GSH-LAN/esp32_env_sensors/esp32_gsh_env_sensors.kicad_sch

## KiCad design esp32_gsh_env_sensors.kicad_sch (2022-03-08, an earlier design)

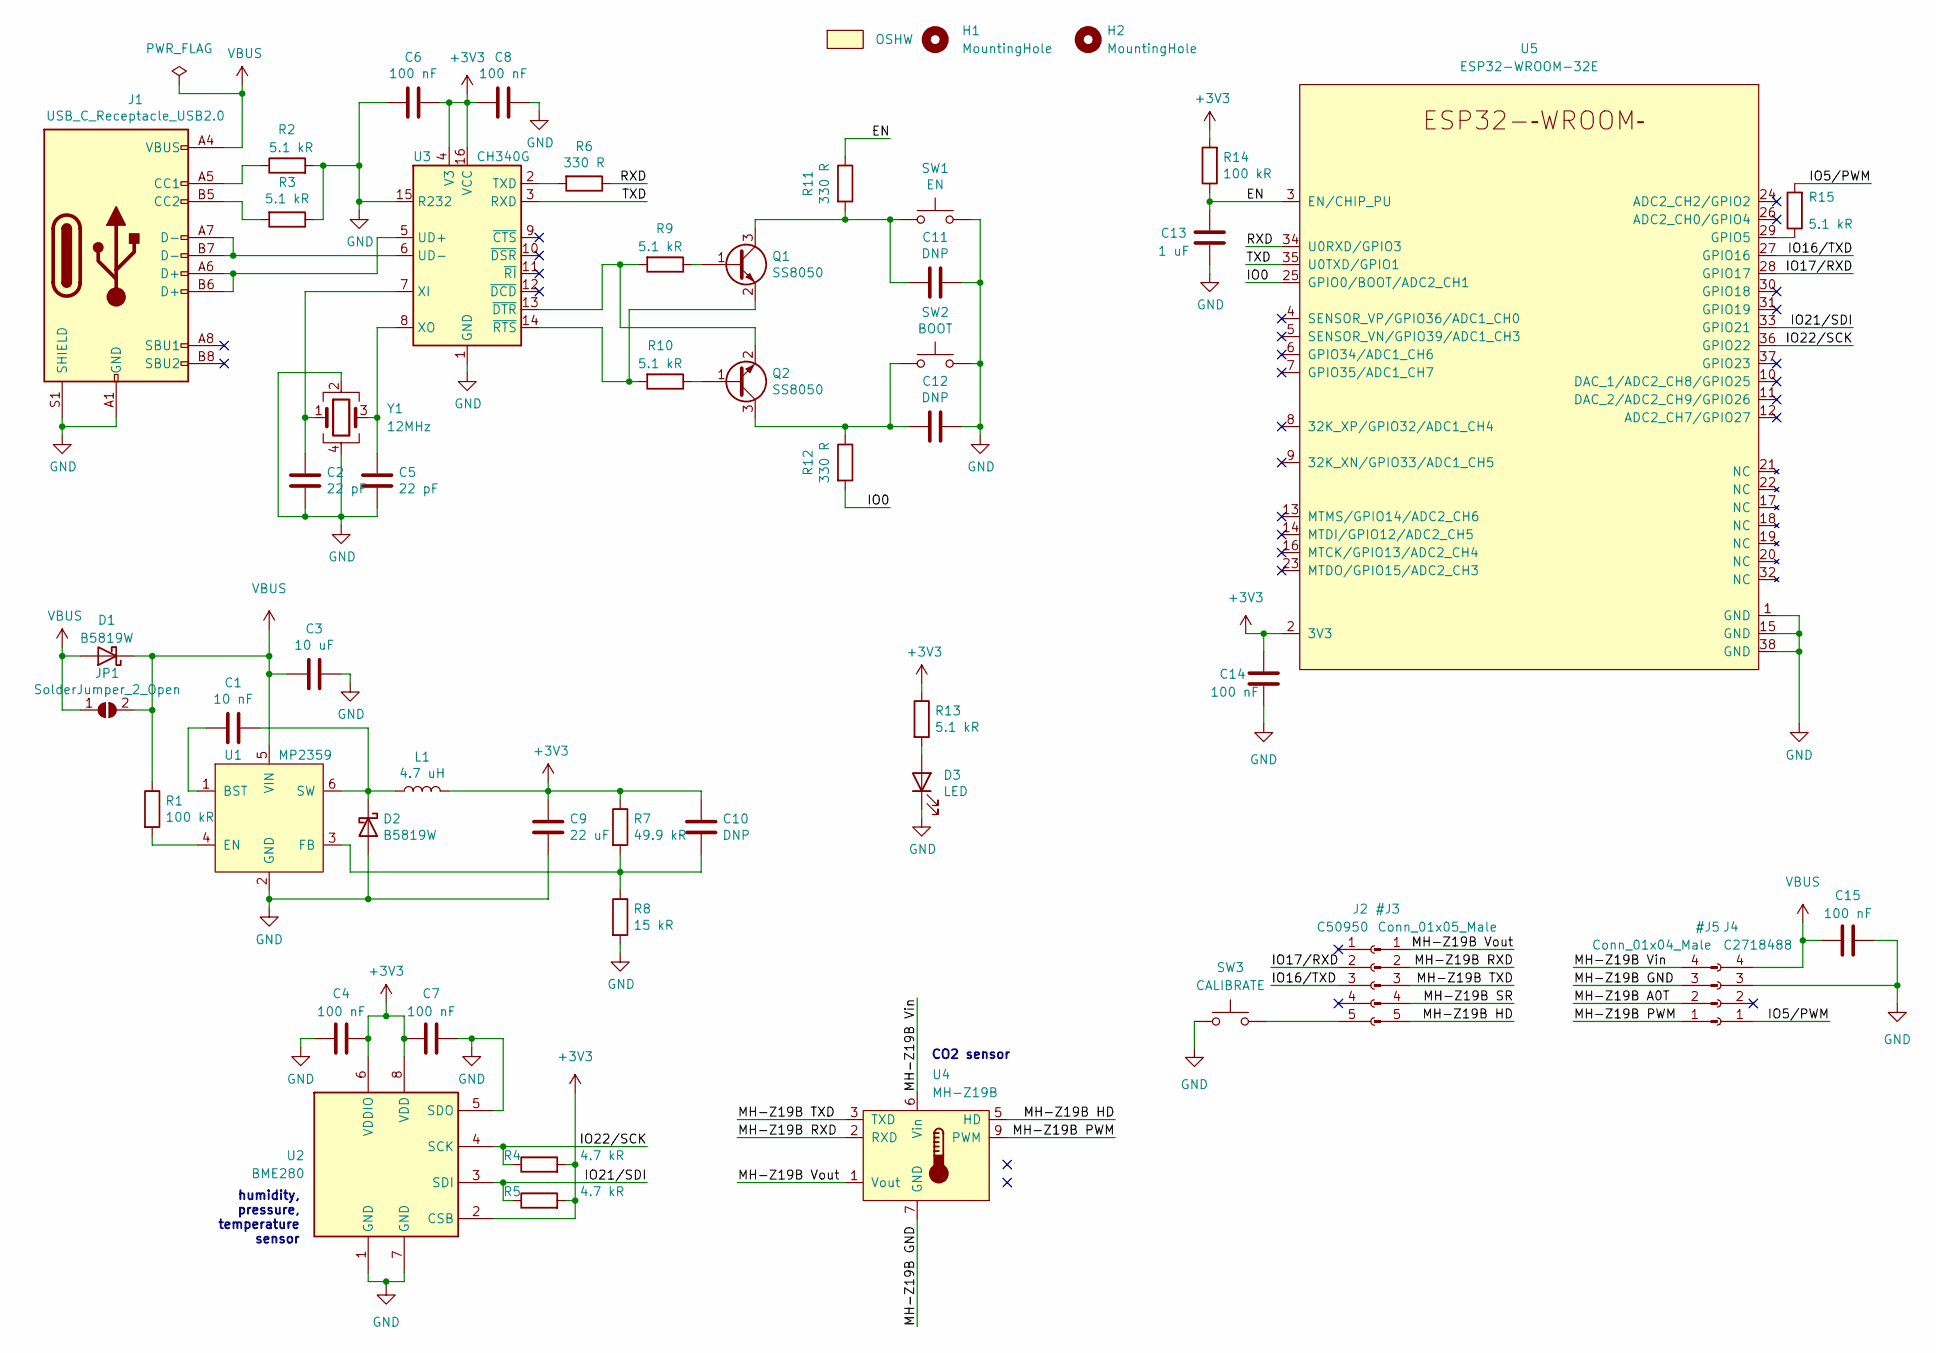
[picture p1: schematic esp32_gsh_env_sensors.kicad_sch]

Parts:
C1: 10 nF; C_0402_1005Metric; LCSC C15195
C2, C5: 22 pF; C_0402_1005Metric; LCSC C1555
C3: 10 uF; C_0805_2012Metric; LCSC C15850
C4, C6, C7, C8, C14, C15: 100 nF; C_0402_1005Metric; LCSC C1525
C9: 22 uF; C_0603_1608Metric; LCSC C59461
C10, C11, C12: DNP; C_0402_1005Metric_Pad0.74x0.62mm_HandSolder
C13: 1 uF; C_0402_1005Metric; LCSC C52923
D1, D2: B5819W; D_SOD-123; LCSC C8598
D3: LED; LED_0603_1608Metric_Castellated; LCSC C2286
H1, H2: MountingHole; ToolingHole_JLCSMT
I1: OSHW; OSHW-Logo2_9.8x8mm_SilkScreen
J1: USB_C_Receptacle_USB2.0; USB_C_Receptacle_Palconn_UTC16-G; LCSC C167321
J2: C50950; PinSocket_1x05_P2.54mm_Vertical; LCSC C50950
J4: C2718488; PinSocket_1x04_P2.54mm_Vertical; LCSC C2718488
JP1: SolderJumper_2_Open; SolderJumper-2_P1.3mm_Open_Pad1.0x1.5mm
L1: 4.7 uH; L_1210_3225Metric; LCSC C86070
Q1, Q2: SS8050; SOT-23; LCSC C2150
R1, R14: 100 kR; R_0402_1005Metric; LCSC C25741
R2, R3, R9, R10, R13, R15: 5.1 kR; R_0402_1005Metric; LCSC C25905
R4, R5: 4.7 kR; R_0402_1005Metric; LCSC C25900
R6, R11, R12: 330 R; R_0402_1005Metric; LCSC C25104
R7: 49.9 kR; R_0402_1005Metric; LCSC C25897
R8: 15 kR; R_0402_1005Metric; LCSC C25756
SW1: EN; SW_Push_SPST_NO_Alps_SKRK; LCSC C115357
SW2: BOOT; SW_Push_SPST_NO_Alps_SKRK; LCSC C115357
SW3: CALIBRATE; SW_Push_SPST_NO_Alps_SKRK; LCSC C115357
U1: MP2359; SOT-23-6; LCSC C14259
U2: BME280; Bosch_LGA-8_2.5x2.5mm_P0.65mm_ClockwisePinNumbering; LCSC C92489
U3: CH340G; SOIC-16_3.9x9.9mm_P1.27mm; LCSC C14267
U4: MH-Z19B; mh-z19b
U5: ESP32-WROOM-32E; LCSC C701343
Y1: 12MHz; Crystal_SMD_3225-4Pin_3.2x2.5mm; LCSC C9002

Connections:
+3V3: C4.2, C6.1, C7.1, C8.2, C9.1, C10.1, C14.1, L1.2, R4.2, R5.2, R7.1, R13.1, R14.2, U2.2 (CSB), U2.6 (VDDIO), U2.8 (VDD), U3.4 (V3), U3.16 (VCC), U5.2 (3V3)
Conn_01x04_Male: U4.6 (Vin), U4.7 (GND), U4.9 (PWM)
Conn_01x05_Male: U4.1 (Vout), U4.2 (RXD), U4.3 (TXD), U4.5 (HD)
EN: C13.1, R11.1, R14.1, U5.3 (EN/CHIP_PU)
GND: C2.2, C3.1, C4.1, C5.2, C6.2, C7.2, C8.1, C9.2, C11.1, C12.1, C13.2, C14.2, C15.2, D2.2 (A), D3.1 (K), J1.A1 (GND), J1.A12 (GND), J1.B1 (GND), J1.B12 (GND), J1.S1 (SHIELD), J4.3, R2.2, R3.1, R8.2, SW1.2, SW2.2, SW3.1, U1.2 (GND), U2.1 (GND), U2.5 (SDO), U2.7 (GND), U3.1 (GND), U3.15 (R232), U5.1 (GND), U5.15 (GND), U5.38 (GND), Y1.2, Y1.4
IO0: R12.2, U5.25 (GPIO0/BOOT/ADC2_CH1)
IO5/PWM: J4.1, R15.2
IO16/TXD: J2.3, U5.27 (GPIO16)
IO17/RXD: J2.2, U5.28 (GPIO17)
IO21/SDI: R5.1, U2.3 (SDI), U5.33 (GPIO21)
IO22/SCK: R4.1, U2.4 (SCK), U5.36 (GPIO22)
unnamed: C1.1, D2.1 (K), L1.1, U1.6 (SW)
unnamed: C1.2, U1.1 (BST)
unnamed: C2.1, U3.7 (XI), Y1.1
unnamed: C5.1, U3.8 (XO), Y1.3
unnamed: C10.2, R7.2, R8.1, U1.3 (FB)
unnamed: C11.2, Q1.3 (C), R11.2, SW1.1
unnamed: C12.2, Q2.3 (C), R12.1, SW2.1
unnamed: D3.2 (A), R13.2
unnamed: J1.A5 (CC1), R2.1
unnamed: J1.A6 (D+), J1.B6 (D+), U3.5 (UD+)
unnamed: J1.A7 (D-), J1.B7 (D-), U3.6 (UD-)
unnamed: J1.B5 (CC2), R3.2
unnamed: J2.5, SW3.2
unnamed: Q1.1 (B), R9.1
unnamed: Q1.2 (E), R10.2, U3.14 (~RTS)
unnamed: Q2.1 (B), R10.1
unnamed: Q2.2 (E), R9.2, U3.13 (~DTR)
unnamed: R1.2, U1.4 (EN)
unnamed: R6.2, U3.2 (TXD)
unnamed: R15.1, U5.29 (GPIO5)
RXD: R6.1, U5.34 (U0RXD/GPIO3)
TXD: U3.3 (RXD), U5.35 (U0TXD/GPIO1)
VBUS: C3.2, C15.1, D1.1 (K), D1.2 (A), J1.A4 (VBUS), J1.A9 (VBUS), J1.B4 (VBUS), J1.B9 (VBUS), J4.4, JP1.1 (A), JP1.2 (B), R1.1, U1.5 (VIN)

Notes on the sheet:
CO2 sensor
humidity, pressure, temperature sensor
