GSH-LAN/esp32_env_sensors/(commit log)

2022-03-06 first commit; WIP
    [esp32_gsh_env_sensors.kicad_pcb, esp32_gsh_env_sensors.kicad_sch]
2022-03-06 Add link to espressives devkit schematics
2022-03-06 Add warning to not use this pcb
2022-03-06 Update schematics
    [esp32_gsh_env_sensors.kicad_sch]
2022-03-07 Multiple fixes, see below
    - Change CH340G to 3.3V power source
    - Fix floating pins (CSB, SDO) for BME280
    - Add pull up resistors to BME280s SCK and SDI pins
    - Fix naming of GPIO5 net (previously IO15/PWM, now IO5/PWM)
    - Add switch to pull down MH-Z19Bs 'HD' pin for calibration
    [esp32_gsh_env_sensors.kicad_sch]
2022-03-07 Fix ch340 3.3V input; Add 5.1kR to protect ESP32; Add PWR_FLAG to schematics
    [esp32_gsh_env_sensors.kicad_sch]
2022-03-07 Get schmeatics ready for layouting
    - Add OSHW logo
    - Add manufacturing mounting holes
    - Assign footprints
    [esp32_gsh_env_sensors.kicad_sch]
2022-03-07 Add LSCS part numbers where available
    [esp32_gsh_env_sensors.kicad_sch]
2022-03-07 Fix title
    [esp32_gsh_env_sensors.kicad_sch]
2022-03-07 Setup PCB sheet
    [esp32_gsh_env_sensors.kicad_pcb]
2022-03-07 Setup PCB layout for JLCPCB manufacturing
    [esp32_gsh_env_sensors.kicad_pcb]
2022-03-07 Fix LED and MH-Z19B footprints
    [esp32_gsh_env_sensors.kicad_sch]
2022-03-08 Update schematics
    - Rename existing mounting holes to tooling holes
    - Add mounting holes
    [esp32_gsh_env_sensors.kicad_sch]
2022-03-08 Fix MH-Z19B wiring
    [esp32_gsh_env_sensors.kicad_sch]
2022-03-08 Change MH-Z19B power input to VCC
    This is required to protect attaced USB equipment
    [esp32_gsh_env_sensors.kicad_sch]
